HuailiZ/PiezoBud/Materials/BOM/BOM_Board1_PCB1_2024-09-30.xlsx

No. | Quantity | Comment | Designator | Footprint | Value | Manufacturer Part | Manufacturer | Supplier Part | Supplier
1 | 1 | 10pF | C1 | C0402 | 10pF | CC0402JRNPO9BN100 | YAGEO(国巨) | C106199 | LCSC
2 | 1 | 1uF | C2 | C0402 | 1uF | CL05A105KP5NNNC | SAMSUNG(三星) | C14445 | LCSC
3 | 1 | 10nF | C3 | C0402 | 10nF | CC0402KRX7R9BB103 | YAGEO(国巨) | C60133 | LCSC
4 | 1 | 100nF | C4 | C0402 | 100nF | CC0402KRX7R7BB104 | YAGEO(国巨) | C60474 | LCSC
5 | 1 | 100pF | C5 | C0402 | 100pF | GRM1555C1H101JA01D | muRata(村田) | C77177 | LCSC
6 | 1 | 10uF | C6 | C0402 | 10uF | GRM155R60J106ME44D | muRata(村田) | C76991 | LCSC
7 | 2 | 10kΩ | R1,R2 | R0201 | 10kΩ | 0201WMF1002TEE | UNI-ROYAL(厚声) | C473048 | LCSC
8 | 1 | 3kΩ | R6 | R0402 | 3kΩ | 0402WGF3001TCE | UNI-ROYAL(厚声) | C25784 | LCSC
9 | 1 | 1kΩ | R7 | R0402 | 1kΩ | 0402WGF1001TCE | UNI-ROYAL(厚声) | C11702 | LCSC
10 | 1 | 8.2kΩ | R8 | R0402 | 8.2kΩ | 0402WGF8201TCE | UNI-ROYAL(厚声) | C25924 | LCSC
11 | 2 | 1MΩ | R9,R10 | R0201 | 1MΩ | RC0201FR-071ML | YAGEO(国巨) | C295786 | LCSC
12 | 3 | 1kΩ | R11,R12,R13 | R0201 | 1kΩ | 0201WMF1001TEE | UNI-ROYAL(厚声) | C270365 | LCSC
13 | 1 | 100kΩ | R14 | RES-ADJ-SMD_TC33X-2-104E | 100kΩ | TC33X-2-104E | BOURNS | C719186 | LCSC
14 | 1 | 22kΩ | R15 | R0201 | 22kΩ | RC0201FR-0722KL | YAGEO(国巨) | C474416 | LCSC
15 | 2 | 200kΩ | R16,R17 | R0201 | 200kΩ | RC0201FR-07200KL | YAGEO(国巨) | C138163 | LCSC
16 | 1 | 2MΩ | R18 | R0201 | 2MΩ | 0201WMF2004TEE | UNI-ROYAL(厚声) | C473556 | LCSC
17 | 1 | X6511FRS-02-C85D30 | U2 | HDR-SMD_2P-P2.54-H-F-L11.5 |  | X6511FRS-02-C85D30 | XKB Connectivity(中国星坤) | C5142235 | LCSC
18 | 1 | LM358BAIDR | U3 | SOIC-8_L4.9-W3.9-P1.27-LS6.0-BL |  | LM358BAIDR | TI(德州仪器) | C1849421 | LCSC
19 | 1 | MAX4466EXK+T | U4 | SC-70-5_L2.0-W1.3-P0.65-LS2.1-BR |  | MAX4466EXK+T | ADI(亚德诺)/MAXIM(美信) | C7456762 | LCSC
20 | 1 | X6511FRS-03-C85D30 | U5 | HDR-SMD_3P-P2.54-H-F-L11.5 |  | X6511FRS-03-C85D30 | XKB Connectivity(中国星坤) | C5142236 | LCSC
