HuailiZ/PiezoBud/Materials/BOM/BOM_Board1_PCB5_2024-09-30.xlsx

No. | Quantity | Comment | Designator | Footprint | Value | Manufacturer Part | Manufacturer | Supplier Part | Supplier
1 | 1 | 2450AT18A100E | AE1 | ANT-SMD_L3.2-W1.6 |  | 2450AT18A100E | JOHANSON(约翰逊) | C89334 | LCSC
2 | 3 | 1uF | C1,C2,C8 | C0402 | 1uF | CL05A105KQ5NNNC | SAMSUNG(三星) | C107372 | LCSC
3 | 1 | 10uF | C3 | C0402 | 10uF | CL05A106MP5NUNC | SAMSUNG(三星) | C315248 | LCSC
4 | 1 | 22uF | C4 | C0402 | 22uF | GRM155R60J226ME11D | muRata(村田) | C415703 | LCSC
5 | 1 | 4.7uF | C5 | C0402 | 4.7uF | C1005X6S0G475M050BC | TDK | C2168059 | LCSC
6 | 3 | 100nF | C9,C10,C11 | C0201 | 100nF | GRM033C71C104KE14D | muRata(村田) | C85923 | LCSC
7 | 1 | 0.5pF | C12 | C0201 | 0.5pF | 0201CG0R5B250NT | FH(风华) | C285115 | LCSC
8 | 2 | 4.7uF | C13,C16 | C0402 | 4.7uF | CL05A475KP5NRNC | SAMSUNG(三星) | C368809 | LCSC
9 | 1 | 47nF | C14 | C0201 | 47nF | CL03A473KQ3NNNC | SAMSUNG(三星) | C318551 | LCSC
10 | 1 | 1uF | C15 | C0402 | 1uF | GRM155R70J105KA12D | muRata(村田) | C88945 | LCSC
11 | 1 | 100nF | C17 | C0201 | 100nF | CL03A104KQ3NNNC | SAMSUNG(三星) | C160831 | LCSC
12 | 3 | 820pF | C18,C23,C24 | C0201 | 820pF | GRM0335C1E821JA01D | muRata(村田) | C384953 | LCSC
13 | 4 | 12pF | C19,C20,C21,C22 | C0201 | 12pF | GRM0335C1E120GA01D | muRata(村田) | C426109 | LCSC
14 | 1 | S2B-PH-SM4-TB(LF)(SN) | CN2 | CONN-SMD_P2.00_S2B-PH-SM4-TB-LF-SN |  | S2B-PH-SM4-TB(LF)(SN) | JST | C295747 | LCSC
15 | 1 | 2.2uH | L1 | L0603 | 2.2uH | SLM16082R2MIT | Sunltech(韩国顺磁) | C206337 | LCSC
16 | 1 | 3.9nH | L2 | IND-SMD_L1.0-W0.5-2 | 3.9nH | LQW15AN3N9C00D | muRata(村田) | C98063 | LCSC
17 | 1 | 2.7nH | L4 | L0201-RD | 2.7nH | LQP03TG2N7B02D | muRata(村田) | C86109 | LCSC
18 | 1 | 10uH | L5 | L0603 | 10uH | MLZ1608N100LT000 | TDK | C194437 | LCSC
19 | 1 | 15nH | L6 | L0201 | 15nH | LQP03TN15NJ02D | muRata(村田) | C206455 | LCSC
20 | 1 | MSM261D3526Z1CM | MIC1 | OCLGA-6_L3.5-W2.7-TL-MSM261D3526Z1CM |  | MSM261D3526Z1CM | MEMS(敏芯微) | C966937 | LCSC
21 | 5 | 0Ω | R1,R2,R4,R17,R19 | R0201 | 0Ω | RC0201JR-070RL | YAGEO(国巨) | C106228 | LCSC
22 | 1 | 56.2kΩ | R3 | R0201 | 56.2kΩ | RC0201FR-0756K2L | YAGEO(国巨) | C327383 | LCSC
23 | 2 | 0Ω | R7,R8 | R0402 | 0Ω | RC0402FR-070RL | YAGEO(国巨) | C106231 | LCSC
24 | 1 | B3U-1000P | SW1 | KEY-SMD_B3U-1000PM |  | B3U-1000P | OMRON(欧姆龙) | C231329 | LCSC
25 | 9 | Test-Point | TP1,TP2,TP4,TP7,TP8,TP9,TP10,TP11,TP12 | Test-Point-0.5mm
26 | 2 | LM66100DCKT | U2,U3 | SC-70-6_L2.0-W1.3-P0.65-LS2.1-BL |  | LM66100DCKT | TI(德州仪器) | C2832141 | LCSC
27 | 1 | MAX38640AENT+ | U4 | WLP-6_L1.4-W0.9-R2-C3-P0.40-TL |  | MAX38640AENT+ | ADI(亚德诺) | C5328753 | LCSC
28 | 1 | X6511FRS-02-C85D30 | U5 | HDR-SMD_2P-P2.54-H-F-L11.5 |  | X6511FRS-02-C85D30 | XKB Connectivity(中国星坤) | C5142235 | LCSC
29 | 1 | X6511FRS-06-C85D30 | U6 | HDR-SMD_6P-P2.54-H-F-L11.5 |  | X6511FRS-06-C85D30 | XKB Connectivity(中国星坤) | C5142239 | LCSC
30 | 1 | NRF52840-QIAA-R | U9 | AQFN-73_L7.0-W7.0-P0.50-BL-EP4.8 | - | NRF52840-QIAA-R | NORDIC | C190794 | LCSC
31 | 1 | 10118193-0001LF | USB1 | MICRO-USB-SMD_10118193-0001LF |  | 10118193-0001LF | Amphenol | C132562 | LCSC
32 | 1 | 32MHz | X1 | CRYSTAL-SMD_4P-L2.0-W1.6-BL | 32MHz | Q22FA12800025 | EPSON(爱普生) | C187794 | LCSC
33 | 1 | 32.768kHz | X2 | CRYSTAL-SMD_L3.2-W1.5-1 | 32.768kHz | NX3215SA-32.768K-STD-MUA-9 | NDK | C519280 | LCSC
