HuailiZ/PiezoBud/Materials/Schematics/SCH_Schematic1_2024-09-30-1.pdf

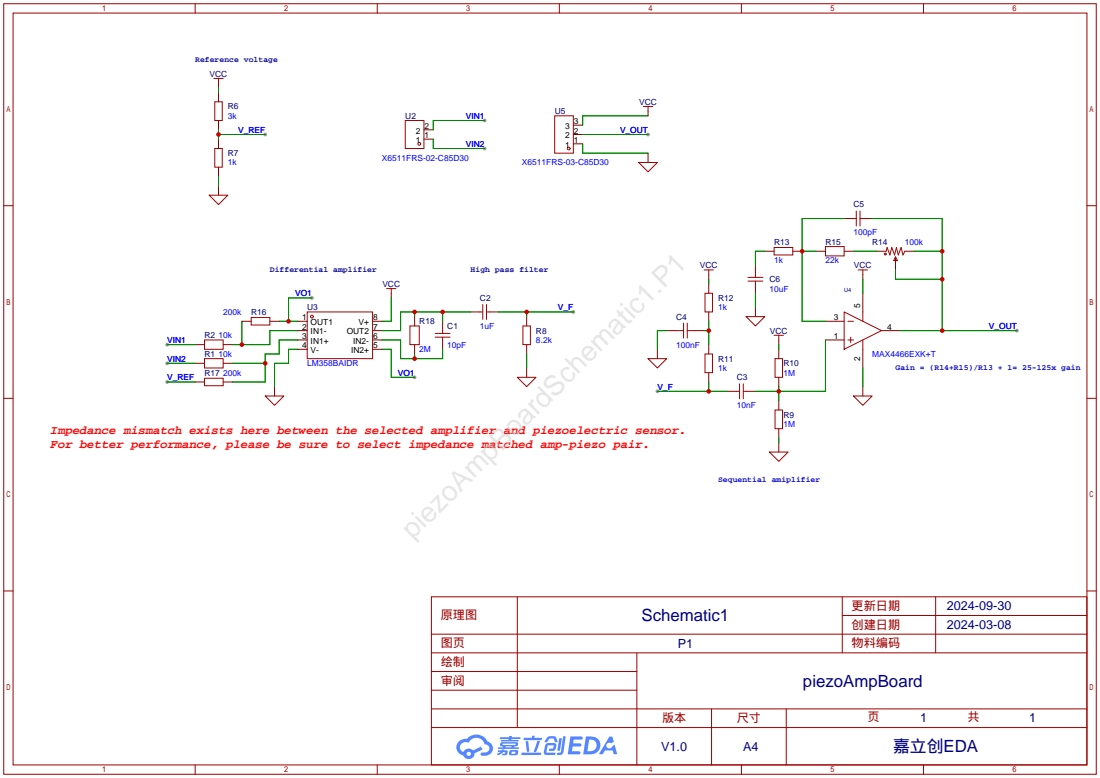
[picture p1: page 1]

For better performance, please be sure to select impedance matched amp-piezo pair. piezoAmpBoardSchematic1.P1

Impedance mismatch exists here between the selected amplifier and piezoelectric sensor.
