HuailiZ/PiezoBud/Materials/Schematics/SCH_Schematic1_2024-09-30-5.pdf

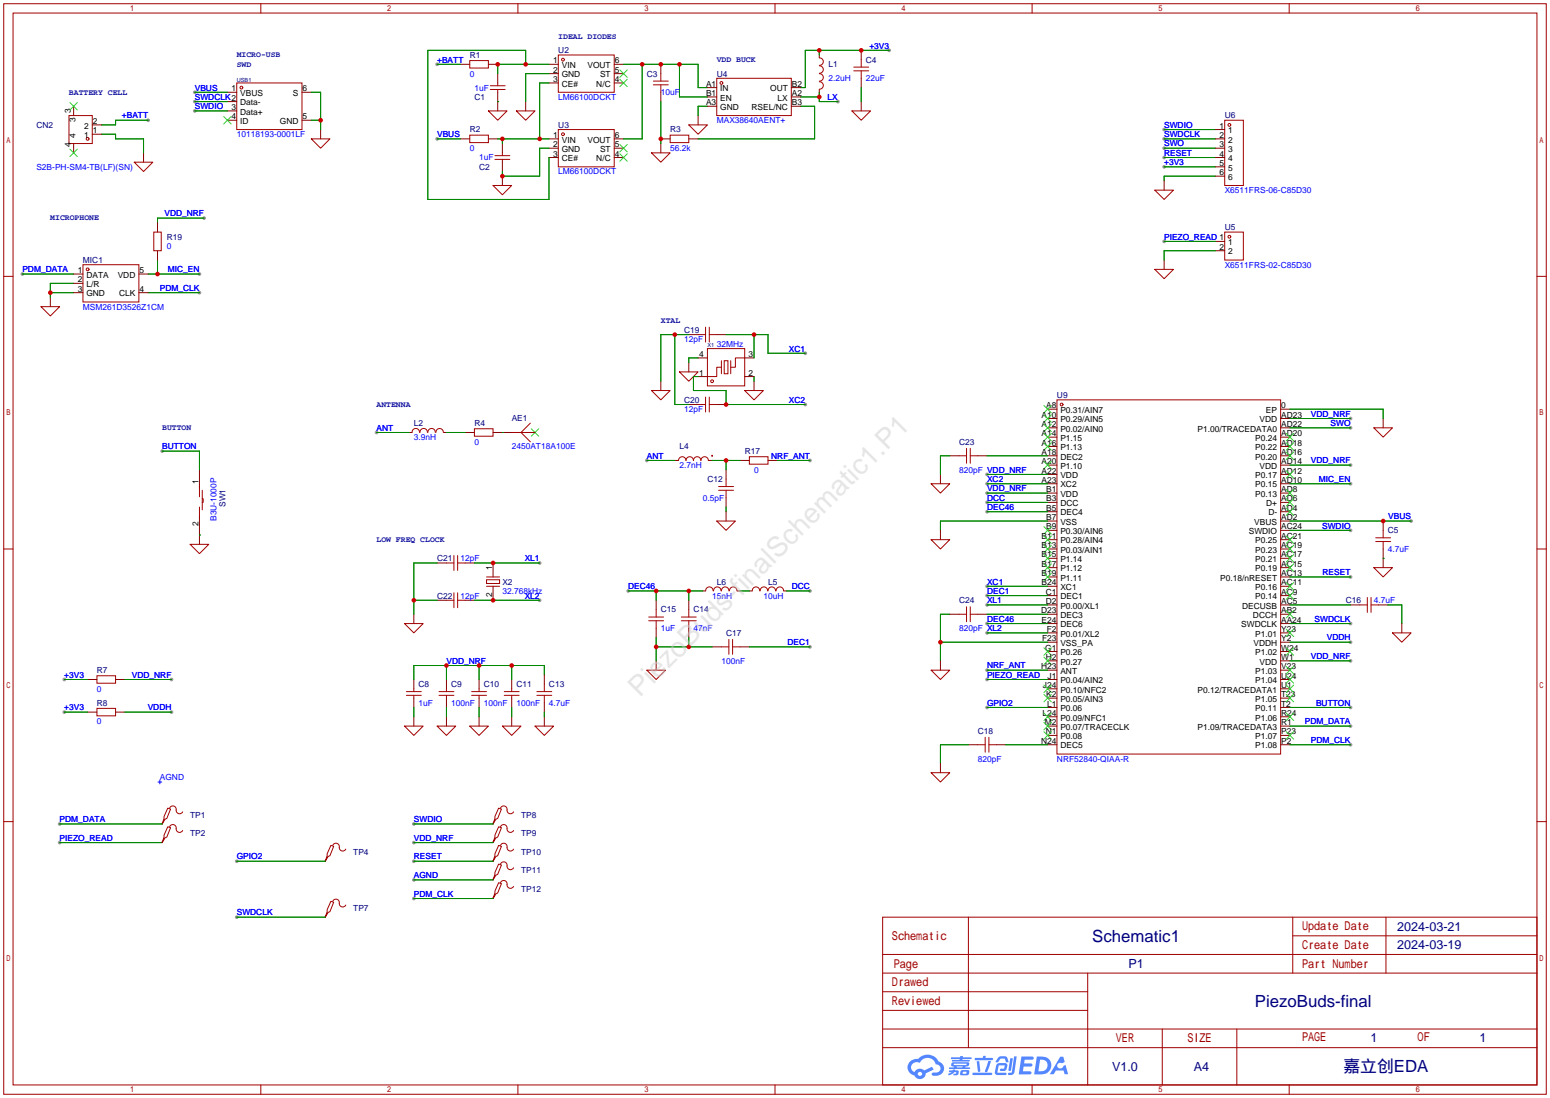
[picture p2: page 1]
