HuailiZ/PiezoBud/(list of files, drawings)

Other design files:
EasyEDA/ProPrj_piezoAmpBoard_2024-09-30.epro
EasyEDA/ProPrj_PiezoBuds-final_2024-09-30.epro
