HuailiZ/PiezoBud/(commit log)

2024-09-30 Add files via upload
    Source files for hardware added.
    [BOM_Board1_PCB1_2024-09-30.xlsx, BOM_Board1_PCB5_2024-09-30.xlsx, PickAndPlace_PCB1_2024-09-30.xlsx, PickAndPlace_PCB5_2024-09-30.xlsx]
2024-09-30 Update README.md
    Add detailed link for each material.
